emathrixacademy/petbottle/docs/sample.jpg

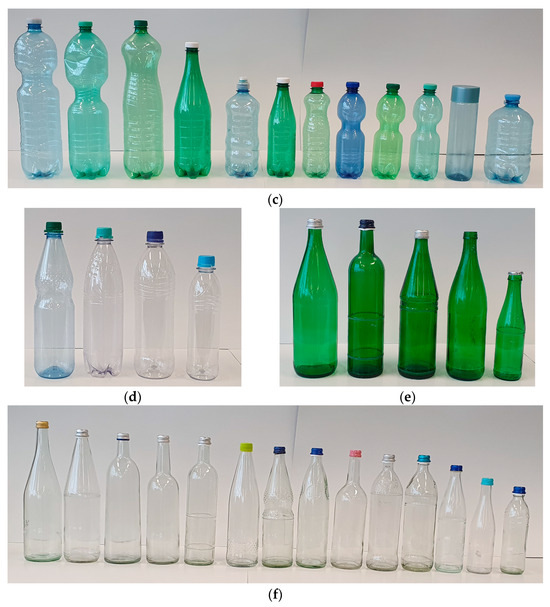
docs/sample.jpg
