emathrixacademy/petbottle/docs/PetBottle_Robotic_Arm_Schematic.pdf

## PET Bottle Robot - Complete Wiring Schematic

ESP32 | Raspberry Pi | Hailo-8 | 3x BTS7960B | L298N | 2x MG996R | 2x HC-SR04 | LCD I2C | 24V

## System Architecture Overview

The PET Bottle Collector Robot uses two processors:
1. Raspberry Pi 5 + Hailo-8 NPU: Camera vision (YOLOv5/v7/v8) + Navigation brain
2. ESP32: Motor control, ultrasonic sensors, WiFi AP, LCD display

Communication: Raspberry Pi connects to ESP32 WiFi AP (192.168.4.1) and sends HTTP commands. ESP32 provides sensor data via GET /sensor endpoint. Communication Diagram

Raspberry Pi 5 | ESP32 (WiFi AP)
+--------------------+ | WiFi | +------------------------+
| CSI Camera | | | | 192.168.4.1 | |
| Hailo-8 NPU | | | | | |
| YOLOv5/v7/v8 | | GET /sensor | | Ultrasonic L/R (cm) | |
| navigator.py <----+<----- JSON ----+--> HC-SR04 x2 | |
| Bottle detected? | | GET /cmd?c=F80 | Drive wheels (BTS7960) |
| Obstacle? | -----+---- command --->| Arm lift (BTS7960) | |
| Pickup! | -----+---- cmd?c=P --->| Servos (MG996R x2) | |
| | | | | Stepper base (L298N) | |
+--------------------+ | | LCD 16x2 + Buzzer | |
+------------------------+
Robot State Machine (navigator.py)
+--------+ | bottle | +------------+ | centered | +----------+
| ROAMING| detected | | APPROACHING| | & close | | ALIGNING |
| (S-curve+----------->| (drive to) +-------------->| (fine | |
| explore)| | +------+-----+ | | adjust) |
+----+----+ | | | +----+-----+
| | | lost bottle | |
| obstacle | | (15 frames) | | aligned
| detected | v | v
+----+----+ | +------+-----+ | +-----+------+
| AVOIDING| | | | ROAMING | | | PICKING UP |
| (back up| | | | | | | (ESP32 P | |
| & turn)| | +------------+ | | command) |
+---------+ | +-----+------+
| done
v
+-----+------+
| ROAMING |
+------------+

## ESP32 GPIO Pin Assignment (21 pins used)

GPIO | Component | Function | Dir
GPIO4 | BTS7960B #1 | Left Wheel RPWM | OUT
GPIO5 | BTS7960B #1 | Left Wheel LPWM | OUT
GPIO26 | BTS7960B #1 | Left Wheel EN | OUT
GPIO2 | BTS7960B #2 | Right Wheel RPWM | OUT
GPIO25 | BTS7960B #2 | Right Wheel LPWM | OUT
GPIO19 | BTS7960B #2 | Right Wheel EN | OUT
GPIO16 | BTS7960B #3 | Arm Lift RPWM | OUT
GPIO17 | BTS7960B #3 | Arm Lift LPWM | OUT
GPIO27 | BTS7960B #3 | Arm Lift EN | OUT
GPIO32 | L298N | Stepper IN1 | OUT
GPIO33 | L298N | Stepper IN2 | OUT
GPIO22 | L298N | Stepper IN3 | OUT
GPIO21 | L298N | Stepper IN4 | OUT
GPIO13 | MG996R Servo L | Left Servo Signal | OUT
GPIO18 | MG996R Servo R | Right Servo Signal | OUT
GPIO14 | LCD I2C | SDA (data) | I/O
GPIO15 | LCD I2C | SCL (clock) | OUT
GPIO23 | Buzzer | Alert Signal | OUT
GPIO12 | HC-SR04 x2 | Shared TRIG | OUT
GPIO34 | HC-SR04 Left | Left ECHO | IN
GPIO35 | HC-SR04 Right | Right ECHO | IN
Used: 21 pins | Free: GPIO 0, 36, 39
WiFi AP: PetBottle_Robot (192.168.4.1) | USB Serial: 115200 baud
GPIO34, GPIO35 = input-only pins (perfect for ultrasonic ECHO)

## 1. Ultrasonic Sensors - HC-SR04 x2 (Obstacle Avoidance)

About HC-SR04

- Measures distance via ultrasonic pulse echo (40kHz)
- Range: 2cm to 400cm, accuracy +/- 3mm
- Operating voltage: 5V
- Trigger pulse: 10us HIGH on TRIG pin
- ECHO pin returns HIGH pulse proportional to distance
- Distance (cm) = pulse duration (us) x 0.034 / 2
Wiring - Left Ultrasonic
HC-SR04 Pin | Connect To | Notes
VCC | 5V (DC-DC out) | Must be 5V, not 3.3V
TRIG | GPIO 12 | Shared with right sensor
ECHO | GPIO 34 | Input-only pin (safe for 5V*)
GND | Common GND | Shared ground

Wiring - Right Ultrasonic

HC-SR04 Pin | Connect To | Notes
VCC | 5V (DC-DC out) | Must be 5V, not 3.3V
TRIG | GPIO 12 | Shared with left sensor
ECHO | GPIO 35 | Input-only pin (safe for 5V*)
GND | Common GND | Shared ground

* GPIO 34/35 are input-only pins with no internal pull-up.
HC-SR04 ECHO outputs 5V. For safety, add a voltage divider:
ECHO --> [1K ohm] --> GPIO34/35 --> [2K ohm] --> GND
This divides 5V to ~3.3V. Many ESP32 boards tolerate 5V on input-only pins, but the divider is recommended.
Mounting Position

FRONT OF ROBOT
+---------------------+
[US-L] | [CSI Camera] | [US-R]
<-- | | lens | | -->
30deg | +--------+ | 30deg
| | [Arm / Servos] | |
+----+ | | +----+
| L | | | | R | Wheels
|Whl | | | |Whl |
+----+ | | +----+
| REAR OF ROBOT

Mount sensors at front corners

Angle outward ~30 degrees for wide coverage Height: same level as chassis (~10cm from ground)
Obstacle Avoidance Thresholds
Distance | Action | Details
< 15 cm | EMERGENCY STOP | Full stop, back up, turn away
15-40 cm | SLOW DOWN | Reduce speed to 50/255
40-60 cm | STEER AWAY | Turn away from closer side
> 60 cm | CLEAR | Full roaming speed (80/255)

ESP32 /sensor API Endpoint

GET http://192.168.4.1/sensor

Response (JSON):
{"left": 45, "right": 120,
"wheels": {"left": 80, "right": 80},
"base": 0, "lift": 0, "motors": 1}

Polled by Raspberry Pi at 10 Hz for real-time obstacle data.
Fused with camera person/object detection for 360-degree awareness.

## 2. Drive Wheels - BTS7960B (HW-039) x2

About the BTS7960B

- High-power 43A H-bridge motor driver
- Operating voltage: 5.5V to 27V (supports 24V directly)
- PWM frequency: up to 25 kHz
- Built-in thermal shutdown and overcurrent protection
- Each board: RPWM, LPWM, R_EN, L_EN, VCC, GND, B+, B-, M+, M-BTS7960B #1 - Left Drive Wheel (24V Motor)
BTS7960B Pin | Connect To | Notes
RPWM | GPIO 4 | Forward PWM (0-255)
LPWM | GPIO 5 | Reverse PWM (0-255)
R_EN | GPIO 26 | Enable (tied with L_EN)
L_EN | GPIO 26 | Enable (tied with R_EN)
VCC | 3.3V (ESP32) | Logic power
GND | Common GND | Shared ground
B+ | 24V Battery + | Via 10A fuse
B- | 24V Battery - | Motor power ground
M+ | Left Motor + | To left wheel motor
M- | Left Motor - | To left wheel motor

BTS7960B #2 - Right Drive Wheel (24V Motor)

BTS7960B Pin | Connect To | Notes
RPWM | GPIO 2 | Forward PWM (boot-safe pin)
LPWM | GPIO 25 | Reverse PWM (0-255)
R_EN | GPIO 19 | Enable (tied with L_EN)
L_EN | GPIO 19 | Enable (tied with R_EN)
VCC | 3.3V (ESP32) | Logic power
GND | Common GND | Shared ground
B+ | 24V Battery + | Via 10A fuse
B- | 24V Battery - | Motor power ground
M+ | Right Motor + | To right wheel motor
M- | Right Motor - | To right wheel motor

BTS7960B Control Logic

RPWM | LPWM | EN | Action
PWM | 0 | HIGH | Forward (variable speed)
0 | PWM | HIGH | Reverse (variable speed)

0 | 0 | HIGH | Coast stop
X | X | LOW | Disabled (emergency stop)

## 3. Arm Lift - BTS7960B #3 (58SW31ZY Motor)

Motor: 58SW31ZY DC Geared Motor

- Voltage: 12-24V DC (runs on 24V from battery)
- Speed: 16 RPM (geared down for torque)
- Used for: Robotic arm vertical lift mechanism
BTS7960B #3 Wiring
BTS7960B Pin | Connect To | Notes
RPWM | GPIO 16 | Lift UP PWM (0-255)
LPWM | GPIO 17 | Lift DOWN PWM (0-255)
R_EN | GPIO 27 | Enable (tied with L_EN)
L_EN | GPIO 27 | Enable (tied with R_EN)
VCC | 3.3V (ESP32) | Logic power
GND | Common GND | Shared ground
B+ | 24V Battery + | Via 10A fuse
B- | 24V Battery - | Motor power ground
M+ | 58SW31ZY + | To arm lift motor
M- | 58SW31ZY - | To arm lift motor

## 4. Base Platform - NEMA 17 Stepper via L298N

Motor: NEMA 17 (200 steps/rev, 1.8 deg/step)

- Used for: Circular turning platform (base rotation)
- Max rotation: +/- 270 degrees
- Driven in FULL4WIRE mode via AccelStepper library
- Coils released after each move to save power
L298N Wiring
L298N Pin | Connect To | Notes
+12V | 24V Battery | Motor power (L298N supports up to 35V)
GND | Common GND | Shared ground
IN1 | GPIO 32 | Stepper coil A+
IN2 | GPIO 33 | Stepper coil A-
IN3 | GPIO 22 | Stepper coil B+
IN4 | GPIO 21 | Stepper coil B-
ENA | Jumper ON | Full current to coil A
ENB | Jumper ON | Full current to coil B
OUT1/OUT2 | NEMA17 Coil A | Motor coil pair 1
OUT3/OUT4 | NEMA17 Coil B | Motor coil pair 2

## 5. Servo Motors - MG996R x2 (Left & Right Arm)

Left Servo (GPIO 13)

Servo Wire | Connect To | Notes
Orange/Signal | GPIO 13 | PWM control (50Hz, LEDC ch6)
Red/VCC | 5V (DC-DC out) | Dedicated 5V 2A+ source
Brown/GND | Common GND | Shared ground

Right Servo (GPIO 18)

Servo Wire | Connect To | Notes
Orange/Signal | GPIO 18 | PWM control (50Hz, LEDC ch7)
Red/VCC | 5V (DC-DC out) | Dedicated 5V 2A+ source
Brown/GND | Common GND | Shared ground
- Open = 0 deg, Close = 90 deg
- O = both open, C = both close
- WARNING: Each MG996R draws up to 2.5A stall.
Use a 5V DC-DC converter rated 5A+ for both servos.

## 6. LCD I2C Display (16x2)

LCD Pin | Connect To | Notes
SDA | GPIO 14 | I2C data line
SCL | GPIO 15 | I2C clock line
VCC | 5V (DC-DC out) | Display power
GND | Common GND | Shared ground
- I2C address: 0x27 (or 0x3F)
- Shows: wheel speed, base angle, lift status, IP address
- Updates every 500ms

## 7. Buzzer

GPIO 23 --> Buzzer (+)
GND --> Buzzer (-)

Active buzzer for startup beep, sequence feedback, emergency alerts.

## 8. Power Distribution

Complete Power Wiring Diagram

[24V 30000mAh ALEAIVY Battery]
[FUSE] | [FUSE] | [FUSE] | [L298N] | [DC-DC 24V->5V 5A]
10A | 10A | 10A | Stepper | |
[BTS#1] | [BTS#2] | [BTS#3] | +----> ESP32 VIN (5V)
L Wheel | R Wheel | Arm Lift | | | |
| | +-> 3.3V -> BTS VCC (x3)
+----> MG996R Left Servo VCC +----> MG996R Right Servo VCC +----> LCD I2C VCC
+----> Buzzer +
+----> HC-SR04 Left VCC
+----> HC-SR04 Right VCC

[ALL GNDs tied to battery negative]
Battery GND -- DC-DC GND -- ESP32 GND -- BTS GND (x3) -- L298N GND -- Servo GND (x2) -- LCD GND -- Buzzer GND -- HC-SR04 GND (x2)
Power Budget
Component | Voltage | Max Current
Left Drive Motor | 24V | 10A (stall)
Right Drive Motor | 24V | 10A (stall)
Arm Lift Motor | 24V | 5A (stall)
NEMA 17 Stepper | 24V | 1.5A
MG996R Servo x2 | 5V | 5A total (stall)
ESP32 | 5V | 0.5A
LCD I2C | 5V | 0.1A
HC-SR04 x2 | 5V | 0.1A
Buzzer | 5V | 0.05A

## 9. Raspberry Pi 5 + Hailo-8 NPU

Raspberry Pi Connections

The Raspberry Pi runs the vision system (YOLOv5/v7/v8) and navigator.
It connects to the ESP32 via WiFi - no physical wiring between them.
Pi Port | Connect To | Notes
CSI Camera | Pi Camera V2/V3 | Ribbon cable to CSI connector
M.2 slot | Hailo-8 NPU | AI accelerator for YOLO inference
USB-C | 5V 5A PSU | Official Pi 5 power supply
WiFi | ESP32 AP | SSID: PetBottle_Robot

Software Stack on Raspberry Pi

camera.py - YOLO model stitching (v5/v7/v8), detection & postprocessing
navigator.py - Autonomous brain: roaming, obstacle avoidance, bottle pickup server.py - OTA update server for remote code deployment

YOLO Models (Hailo HEF format):
yolov5s.hef | - 16 MB, COCO pretrained, FAR range specialist
yolov7.hef | - 55 MB, COCO pretrained, MID range specialist
yolov8s-coco.hef - 35 MB, COCO pretrained, CLOSE range specialist

Detection: COCO class 39 (bottle) - all orientations (standing, lying, tilted) Filtering: Bottles held by humans (COCO class 0) are excluded.
Toggle live: press 5/7/8/A during camera view to switch models.
Sensor Fusion

The navigator fuses two data sources for 360-degree awareness:

1. CAMERA (Raspberry Pi + Hailo-8):
- Detects bottles (target) and persons (avoid)
- Estimates distance by bounding box fill ratio
- Guides approach angle to center bottle in frame
2. ULTRASONIC (ESP32, via /sensor endpoint):
- Left and right distance readings (cm)
- Detects walls, furniture, obstacles camera cannot see
- Polled at 10 Hz over WiFi HTTP

Decision priority: Ultrasonic STOP > Camera person avoid > Bottle approach > Roam

## 10. Command Reference (Serial + WiFi)

USB Serial: 115200 baud | WiFi AP: PetBottle_Robot (petbottle123)
Web UI: http://192.168.4.1 | API: /cmd?c=<CMD> | Sensors: /sensor
Drive Wheels
Command | Description
F<speed> | Drive forward (0-255, default 80)
J<speed> | Drive backward (0-255)
TL<speed> | Turn left (left reverse, right forward)
TR<speed> | Turn right (left forward, right reverse)
W<l>,<r> | Raw wheel control (-255 to 255). E.g. W100,-50
X | Stop both wheels immediately

Base / Lift / Servos

Command | Description
B<angle> | Rotate base (-270 to +270 deg)
BH | Home base to 0 degrees
U<speed> | Lift arm UP (0-255)
D<speed> | Lift arm DOWN (0-255)
S | Stop lift motor
L<angle> | Left servo (0-180 deg)
R<angle> | Right servo (0-180 deg)
O | Both servos open (0 deg)
C | Both servos close (90 deg)

System

Command | Description
P | Full pickup sequence (lower, grab, lift, rotate, drop, home)
H | Home all motors (wheels stop, lift up, servos open, base 0)
E | EMERGENCY STOP - all motors off, EN pins LOW
? | Show help and current status

Pickup Sequence (Command: P)

1. Stop wheels, open both servos
2. Lower arm (speed 150, 3 seconds)
3. Close both servos (grab bottle)
4. Lift arm (speed 200, 3 seconds)
5. Rotate base to 180 degrees (bin on top)
6. Lower slightly (speed 120, 1 second)
7. Open both servos (release bottle into bin)
8. Lift arm back up (speed 200, 1.5 seconds)
9. Return to home position (base 0, servos open)

Triggered automatically by navigator.py when bottle is centered and close enough (fills >15% of camera frame).

## 11. Safety Notes

BOOT SAFETY:
- GPIO2 (Right RPWM) has built-in pull-down: stays LOW at boot.
- All EN pins start LOW (drivers disabled) until PWM is zeroed.
- Default speed: 80/255 (~31%) for safe testing.

FUSES: Add 10A fuse on each BTS7960B B+ line.

ULTRASONIC SAFETY:
- Add voltage divider (1K+2K) on ECHO lines for 5V->3.3V.
- 15ms delay between left/right readings prevents crosstalk.
- Timeout: 30ms (30000us) prevents blocking on no echo.

NAVIGATOR SAFETY:
- Emergency stop if ultrasonic < 15cm on either side.
- Camera detects persons - robot avoids if person fills >20% of frame.
- Pickup sequence stops wheels first, then operates arm.
- Lost WiFi: robot keeps last known sensor data, stops on timeout.

EMERGENCY STOP (E): Disables all motor drivers immediately. Send 'H' to re-enable and home all axes.

GROUND RULE: ALL GNDs must be tied together - battery, DC-DC, ESP32, BTS7960B (x3), L298N, servos, LCD, buzzer, HC-SR04 (x2).

## 12. Bill of Materials

Qty | Component | Model | Purpose
1 | ESP32 Dev Board | ESP32-D0WD | Motor/sensor controller
1 | Raspberry Pi 5 | RPi 5 4/8GB | Vision + navigation brain
1 | Hailo-8 NPU | M.2 module | YOLO AI accelerator
1 | Pi Camera | V2 or V3 | Bottle/obstacle detection
3 | BTS7960B Motor Driver | HW-039 | 43A H-bridge
1 | L298N Motor Driver | L298N | Stepper driver
2 | HC-SR04 Ultrasonic | HC-SR04 | Obstacle distance
2 | 24V DC Motor | - | Drive wheels (L/R)
1 | DC Geared Motor | 58SW31ZY | Arm lift
1 | Stepper Motor | NEMA 17 | Base rotation
2 | Servo Motor | MG996R | Left/Right arm grab
1 | LCD I2C Display | 16x2 PCF8574 | Status display
1 | Active Buzzer | - | Audio alerts
1 | Lithium Battery | 24V 30Ah | Main power
1 | DC-DC Converter | 24V->5V 5A | Logic/servo power
3 | Blade Fuse + Holder | 10A | Driver protection
2 | Resistor 1K ohm | - | Ultrasonic voltage divider
2 | Resistor 2K ohm | - | Ultrasonic voltage divider

Software Files

File | Description
robotic_arm.ino | ESP32 firmware: motors, sensors, WiFi AP, /sensor API
camera.py | YOLO v5/v7/v8 model stitching, detection, postprocessing
navigator.py | Autonomous brain: roam, avoid, approach, pickup
server.py | OTA update server for remote code deployment
yolov5s.hef | YOLOv5s COCO model (Hailo HEF, 16MB)
yolov7.hef | YOLOv7 COCO model (Hailo HEF, 55MB)
yolov8s-coco.hef | YOLOv8s COCO model (Hailo HEF, 35MB)
