emathrixacademy/petbottle/(commit log)

2026-02-27 add camera streaming functionality using Picamera2
2026-02-27 refactor camera streaming implementation and add Flask routes for live feed
2026-02-27 refactor camera.py to remove Flask integration and streamline camera preview functionality
2026-02-27 refactor camera.py to enhance frame generation and improve Flask integration for live video feed
2026-02-27 refactor camera.py to explicitly request RGB format and enhance HTML interface for better clarity
2026-02-27 refactor camera.py to improve camera initialization and enhance HTML interface for clarity
2026-02-27 refactor camera.py to enhance camera setup, enable HDR, and improve HTML interface for better clarity
2026-03-01 Refactor camera setup and remove YOLO integration for improved performance
2026-03-01 Refactor camera setup and integrate AI inference for object detection
2026-03-01 Refactor camera setup to replace YOLO with Hailo HEF acceleration for PET bottle detection
    [camera.py]
2026-03-01 Fix postprocessing for output shapes and improve anchor generation in PET bottle detection
    [camera.py]
2026-03-01 Refactor camera.py to enhance detection overlay, improve snapshot functionality, and update postprocessing logic
2026-03-01 Add initial test suite for camera functionality
2026-03-06 Fix camera capture: use picamera2 for Pi Camera CSI ribbon
    [camera.py]
2026-03-06 Fix --image single file path and hardcode petbottle output layer names
    [camera.py]
2026-03-06 Add debug max_conf print to diagnose zero detections
2026-03-06 Set default conf threshold to 0.01 for petbottle.hef, remove debug print
2026-03-06 Apply sigmoid to confidence output to fix low scores from HEF export
    [camera.py]
2026-03-06 Revert sigmoid (HEF already has it), set conf=0.01 for petbottle.hef
    [camera.py]
2026-03-06 Fix purple colors from picamera2 RGB output, reduce false positives
    [camera.py]
2026-03-06 Tighten NMS IoU to 0.3 and raise conf threshold to 0.05
    [camera.py]
2026-03-06 Raise conf to 0.25, add aspect ratio filter to reduce false positives
2026-03-06 Fix COCO model input size: read from HEF instead of hardcoding 416x416
    [camera.py]
2026-03-06 Replace aspect ratio filter with size+orientation filter to support laid-down bottles
    [camera.py]
2026-04-06 Add YOLO model stitching (v5/v7/v8), autonomous navigator, and ultrasonic obstacle avoidance
    - camera.py: YOLOv5/v7/v8 model stitching with live toggle (5/7/8/A keys),
    range-based specialization, held-by-human filtering, person detection
    - navigator.py: Autonomous brain fusing camera + ultrasonic sensors,
    state machine (roam/approach/align/pickup/avoid), ESP32 WiFi control
    - robotic_arm.ino: Added HC-SR04 ultrasonic sensors (GPIO 12/34/35),
    GET /sensor JSON endpoint for Pi communication
    - server.py: OTA update server for remote deployment
    - Updated wiring schematic PDF (12 pages) with full system architecture
    [partitions.csv]
2026-04-10 Fix right wheel reverse and backward: LEDC channel pairing + pin swap
    - Fix LEDC PWM: replace ledcAttachChannel (v3 API) with ledcSetup/ledcAttachPin
    (v2 API) for compatibility with ESP32 Arduino core 2.0.17
    - Fix channel pairing: assign channels in natural timer pairs (0/1, 2/3, 4/5)
    so each motor's forward/reverse share the same hardware timer — prevents
    the out-of-order timer re-init bug that killed right-wheel reverse (ch1)
    - Swap Right Wheel pins (2,25,19) with Arm Lift pins (16,17,27) to isolate
    potential BTS7960B hardware fault on the right driver board
    - Add flash_ota.bat: one-click compile + WiFi switch + OTA upload + reconnect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
2026-04-11 Add README/CLAUDE docs and cap drive wheel speed to 100
    - Add README.md: full project documentation (architecture, hardware, setup, API)
    - Add CLAUDE.md: project context for Claude Code (pin maps, build rules, known issues)
    - Cap wheel speed to DRIVE_MAX=100 (~39% duty) in set_wheels() for safety
    - Update web UI slider max from 255 to 100
2026-04-11 Add web detection app, fix Hailo-8 model configs, add OTA to sensor sketch
    - web_detect.py: Flask web app streaming live camera + YOLO detection via
    MJPEG at http://0.0.0.0:5000, with model switching (v5/v7/v8/ensemble)
    and real-time stats (FPS, inference time, bottle/person count)
    - camera.py: Switch to Hailo-8 native models (yolov5s_h8.hef, yolov7_h8.hef)
    with built-in NMS — fixes corrupted output from Hailo-8L compiled models.
    Fix ModelManager.activate() to activate network group before opening
    inference pipeline, and store activation context for proper cleanup.
    - petbottle/petbottle.ino: Add WiFi AP + WebServer + OTA firmware update
    (legacy sensor-only sketch, kept for refe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
    [camera.py]
2026-04-12 Cap drive speed to 80, update obstacle avoidance for 1m robot
    - robotic_arm.ino: DRIVE_MAX=80 (drivers explode above 100), default=60,
    web UI slider capped 30-80
    - navigator.py: all speeds under 80 (roam=60, turn=50, approach=40, slow=35),
    obstacle thresholds widened for 1m robot (stop=50cm, slow=80cm, turn=120cm)
    - camera.py: Hailo-8 native models with proper network group activation
    - web_detect.py: Flask web app for browser-based detection viewing
    - robotic_arm.bin: pre-compiled firmware ready for OTA flash
    [navigator.py]
2026-04-13 Restructure repo, white-blue web UI, fix ARM_IN1 strapping pin, add static IPs
    - Reorganize files into esp32_test/, raspi/, models/, docs/, tools/
    - Redesign ESP32 web dashboard and OTA page with clean white and blue theme
    - Fix ARM_IN1: GPIO 0 (strapping pin) -> GPIO 15 to prevent flash lockout
    - Invert arm motor polarity in software (up button was going down)
    - Add limit switch auto-detect: skip check when no pull-ups installed
    - Lock ESP32 AP to static IP 192.168.4.1 via softAPConfig
    - Add Pi static IP 192.168.4.4 config in setup_hailo.sh
    - Fix setTab() implicit event variable bug
    - Remove dead ANSI escape code in pollCmdLog
    - Delete old build artifacts and legacy sketches
    - Update CLAUDE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
    [partitions.csv]
2026-04-16 Clean repo: add Hailo driver tooling, tune arm/swing UI ranges, ignore large binaries
    - esp32_test: arm slider 25-180, swing slider 30-80 (was 50-255)
    - Add .gitignore entries for *.log, fromgooglecolab/, models/archive/
    - Remove large model binaries from tracking (backed up separately)
    - Remove legacy raspi/sample.py and raspi/web_detect.py
    - Add YOLOv8 PET bottle training notebook
2026-04-18 Add Pi fallback AP, swap arm to Hybrid 2R0, refine obstacle UI
    - raspi/setup_fallback_ap.sh: Pi self-sufficient access — broadcasts
    PiRobot hotspot (192.168.50.1) when no known WiFi in range, watchdog
    auto-switches back when a known SSID reappears. Removes reliance on
    Tailscale / phone-hotspot tricks for SSH access.
    - esp32_test.ino: arm lift moved from L298N #1 to e-Gizmo Hybrid 2R0
    (PWM=14, DIR=19). DIR off GPIO 15 (strapping pin); GPIO 15 reused
    for E18-D80NK IR proximity sensor. Added manual pulsed-down safety
    profile, mirrored servo scoop angles, lowered default arm speed.
    - pi_admin.py: four-tier obstacle coloring (stop/slow/warn/clear)
    matching navigator thresholds (60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
    [esp32_test.ino, pi_admin.py]
2026-04-19 USB-serial transport, IR bin-full mission end, safety hardening
    - Swap Pi<->ESP32 control link from WiFi/HTTP to USB serial (115200 baud,
    line-based ASCII + 10 Hz JSON sensor push). Adds ESP32SerialLink with
    port auto-detect and background reader thread.
    - End mission on E18-D80NK IR proximity sensor (debounced) instead of a
    fixed bottle count. MISSION_COMPLETE is sticky until operator restart.
    - ESP32 wheel watchdog: stop motors if no Pi command for >1 s.
    - Web /cmd auto-locks while Pi serial is active (PISTOP/PIX/PA exempt).
    - Clamp swing PWM to 150; reset verify/approach counters on AVOIDING;
    AVOIDING re-checks front clearance before resuming SCANNING.
    - All ESP32 motor speeds def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
    [camera.py, esp32_test.ino, navigator.py]
2026-04-19 Restore arm lift motor speeds, default all sliders to 30
    Arm/pickup speeds were accidentally zeroed out, disabling the motor.
    Restored working values (127/180/100/255) and set default UI slider
    and armSpeed to 30 for a gentler start.
2026-04-19 Include .bin firmware in repo for OTA flashing
    Updated .gitignore to track .bin files in build directories.
    Added compiled esp32_test.ino.bin.
2026-04-20 Lower arm down speed to 80 to reduce motor stress
    Reduced MANUAL_DOWN_SPEED (127→80) and PU_LOWER_SPEED (100→80)
    for gentler pulsed lowering, preventing motor damage.
    [esp32_test.ino]
2026-04-20 Set arm default speed to 20, cap max at 120
    Reduced arm PWM defaults and slider range for motor protection.
    MANUAL_UP_SPEED capped at 120 to match new max.
2026-04-20 Restore arm max speed to 180
    Slider max and MANUAL_UP_SPEED back to 180, default stays at 20.
2026-04-20 Replace USB serial with BLE UART for Pi-ESP32 communication
    ESP32 now runs a BLE GATT server (Nordic UART Service) advertising
    as "PetBottle_Robot". Pi navigator connects via bleak library.
    Same PI-prefixed command protocol, same JSON sensor packets.
    - ESP32: added BLE server with TX notify + RX write characteristics
    - Pi: replaced pyserial ESP32SerialLink with bleak ESP32BLELink
    - Sensor push slowed from 100ms to 200ms for BLE throughput
    - USB Serial kept for Arduino IDE debug only, not Pi commands
    - WiFi AP still available for OTA and web dashboard
    - CLAUDE.md updated to reflect BLE transport
    [esp32_test.ino, navigator.py]
2026-04-20 Fix BLE connection: force LE transport, increase timeout
    - Added transport="le" to prevent BlueZ classic BT fallback
    - Increased connection timeout to 20s (ESP32 WiFi+BLE coexistence)
    - Increased init wait to 30s for slower BLE discovery
    - Explicit connect/disconnect for better error recovery
    [navigator.py]
2026-04-20 Add model switching, data logging, full dashboard to navigator
    - YOLOv5/v7/v8 model switch buttons on dashboard
    - CSV data recording: detections, bottle distance, avoidances, pickups
    - Ultrasonic distance display with color coding
    - BLE connection status indicator
    - Pi->ESP32 command log panel
    - Download CSV log for model comparison
    - Non-blocking BLE: camera starts immediately, ESP32 connects in background
    [navigator.py]
2026-04-20 Update pi_admin dashboard: WiFi → BLE status, add cmd log + nav CSV
    - Replace WiFi connect/disconnect with live BLE status from navigator
    - Add pickups/avoidances counters to detection stats
    - Add Pi→ESP32 command log panel (polled from navigator)
    - Add navigation CSV download button
    - Add MISSION_COMPLETE state color
    - Remove unused nmcli/WiFi routes and imports
    - Add pi_admin.py to CLAUDE.md key files
    [pi_admin.py]
2026-04-20 Fix web UI turning: set default wheelSpeed and turnSpeed to 40
    turnSpeed and wheelSpeed were 0, so web UI left/right turn commands
    did nothing (setLeft(0), setRight(0)). Pi commands unaffected since
    they pass their own speed values.
    [esp32_test.ino]
2026-04-20 Fix wheel speeds: forward/backward fixed at 60, turn default 50 adjustable
    - wheelSpeed is now const 60 — no way to change via UI or commands
    - turnSpeed defaults to 50, adjustable with +/- buttons
    - Pi navigator commands (PIFW/PIBW/PITL/PITR) keep variable speed for navigation
    [esp32_test.ino]
2026-04-22 Swap LIMIT_2/IR_PROX pins, slow arm down, extend servo wait times
    - Swap GPIO 39 (LIMIT_2) → GPIO 15 (internal pull-up) to fix always-pressed issue
    - Swap GPIO 15 (IR_PROX) → GPIO 39 (needs external 10k pull-up)
    - Reduce manual arm down speed from 80 to 60 PWM
    - Increase scoop close and drop open wait from 800ms to 1000ms
    [esp32_test.ino]
2026-04-22 Switch Pi-ESP32 communication from BLE to WiFi HTTP, add Pi OTA upload
    - Replace ESP32BLELink with ESP32WiFiLink in navigator.py
    (commands via GET /cmd?c=, sensor polling via GET /sensor every 200ms)
    - Remove bleak dependency, use urllib instead
    - Update pickup servo wait times to 3000ms
    - Add /upload page to pi_admin.py for OTA Python file updates
    - Update dashboard labels from BLE to WiFi
    [esp32_test.ino, navigator.py, pi_admin.py]
2026-04-22 Switch Pi-ESP32 communication from BLE to WiFi HTTP, add Pi OTA upload
    - Remove all BLE code from ESP32 firmware (82% → 41% flash)
    - Pi navigator uses WiFi HTTP: GET /cmd?c=<CMD> and GET /sensor
    - WiFi-only = more stable, no BLE coexistence issues
    - Dashboard shows WiFi connection status instead of BLE
    - Pi auto-connects to ESP32 WiFi AP on boot
    [esp32_test.ino, navigator.py, pi_admin.py]
2026-04-22 Swap LIMIT_2/IR_PROX pins, slow arm down, extend servo wait times
    - Scoop close wait: 3s → 1s for faster grab
    - Drop open wait: 3s → 10s to ensure bottle falls into bin
    - Lift speed at max 255
    - Removed BLE stack (WiFi-only communication)
    [esp32_test.ino]
2026-04-22 Fix PISTOP to abort pickup, navigator stop uses emergency_stop, add wiring schematic
    - ESP32: PISTOP now calls pickupAbort() before stopAll() so pickup sequence truly stops
    - Navigator: /stop route sends PISTOP (emergency_stop) instead of PIX (wheels only)
    - Add WIRING_SCHEMATIC.md with full ASCII wiring diagrams
    [esp32_test.ino, navigator.py]
2026-04-26 Switch Pi-ESP32 communication from WiFi AP to mobile hotspot STA mode
    ESP32 now connects to phone hotspot as STA client (static IP 192.168.43.100)
    instead of running its own AP. Stronger signal, better range, internet access
    for both devices. Removed all BLE references from codebase and docs.
2026-04-26 Update hotspot SSID to petbottle_hotspot to avoid conflict with ESP32 AP name
    [esp32_test.ino]
2026-04-26 Set device hostnames: esp32_petbottle and raspi_petbottle
2026-04-26 Remove static IP, add auto-discovery so ESP32 works on any phone hotspot
    Navigator scans the local network for the ESP32's /sensor endpoint at
    startup. Works regardless of what subnet the phone DHCP assigns.
2026-04-26 Add AI vision verification and scene analysis to navigator
    - verify_target: confirms PET bottle after YOLO detection (VERIFYING state)
    - analyze_scene: suggests navigation direction when scanning finds nothing
    - assess_obstacle: identifies obstacles and recommends avoidance direction
    All AI calls run in background threads to avoid blocking the main loop.
    Falls back to YOLO-only if API is unavailable.
    [navigator.py, vision_ai.py]
2026-04-26 Add manual controls dashboard and PI-prefixed commands for all actuators
    ESP32: Add PIAU/PIAD/PIAS (arm), PISWL/PISWR/PISWS (swing), PISO/PISC
    (servos), PIBZ/PIBZL (buzzer) commands that bypass mode system.
    Pi dashboard: Reorganize into 3 tabs (Autonomous, Manual Control, Data)
    with touch-friendly D-pad, speed slider, arm/swing/servo/buzzer controls,
    live sensor readout, and pickup sequence buttons. All commands route
    through Pi to ESP32 via WiFi HTTP.
    [esp32_test.ino, pi_admin.py]
2026-04-27 Update arm lift: soft ramp-up, continuous motion, servo swap labels, servos open on boot
    - Remove pulsed arm motion, use continuous drive (stable 19V/12V supply)
    - Add soft ramp-up on arm lift to avoid PSU overcurrent trip
    - Servos open on boot for scooper replacement
    - Swap servo Open/Close button labels to match actual wiring
    - Remove PI arm/swing/servo/buzzer commands (wheel + stop only)
    - Slower pickup sequence timing, 45s timeout
    - Update flash_ota.bat for esp32_test sketch
    [esp32_test.ino]
2026-04-27 Update arm lift: reduce manual down speed from 60 to 35 PWM
2026-04-27 Update arm lift: soft ramp-up, continuous motion, servo swap labels, servos open on boot
    [esp32_test.ino]
2026-04-28 Fix inverted scooper servos: swap OPEN/CLOSE values so scoopers match real-world direction
    [esp32_test.ino]
2026-04-28 Fix navigator exiting when ESP32 not yet on hotspot — retry discovery forever
    The navigator was exiting immediately if ESP32 wasn't found during the
    first 30s scan. Now it retries every 10s until the ESP32 joins the
    hotspot, so boot order no longer matters.
    [navigator.py]
2026-04-28 Fix critical bug: set lastPiCmdMs on PI commands so watchdog doesn't kill wheels
    Without this, the wheel watchdog (1s timeout) immediately stops all wheel
    movement during autonomous mode because lastPiCmdMs was never updated.
    The wheels would start spinning then stop 1 second later.
    [esp32_test.ino]
2026-04-28 Fix ESP32 disconnect during autonomous: deduplicate commands to prevent flooding
    Navigator was sending the same motor command (PITL/PITR) 52 times per
    second (once per frame). The ESP32's single-threaded web server choked,
    causing timeouts and disconnects. Now identical consecutive commands are
    skipped — only state changes trigger a new HTTP request.
    [navigator.py]
2026-04-28 Fix all autonomous mode blockers: sensor resilience, state transitions, throttling
    - /start now accepts STOPPED and MISSION_COMPLETE states (not just WAITING)
    - Command throttle: 150ms minimum between commands, full dedup including PIX
    - Sensor poll: requires 5 consecutive failures before declaring disconnect
    (was: 1 failure instantly killed connection and forced STOPPED)
    - SENSOR_STALE raised from 2s to 5s (WiFi jitter tolerance)
    - INFER_FAIL_LIMIT raised from 3 to 15 (don't force STOPPED on transient errors)
    [navigator.py]
2026-04-28 Fix ECHO_4 pin: was GPIO 0 (boot pin, garbage readings) now correct GPIO 34
    GPIO 0 is a boot strapping pin that gives unreliable readings as an
    ultrasonic echo input. This caused false close-distance readings on
    sensor S4 (left), triggering unnecessary obstacle avoidance during
    autonomous mode. Fixed to GPIO 34 per the schematic.
    [esp32_test.ino]
2026-04-28 Fix emergency stop, servo direction, swing drive, auto-start, and command routing
    - Emergency stop: background threads (pickup, AI scan, AI verify) now
    respect WAITING state instead of overwriting it back to SCANNING.
    WAITING/STOPPED states send PISTOP every 2s as safety net.
    - Servo direction swapped: OPEN_L=0/OPEN_R=180, CLOSE_L=180/CLOSE_R=0
    - Arm speeds adjusted: UP=153, DOWN=40
    - Swing speed set to 35, separate dedup tracking (2s window) so swing
    commands don't get blocked by wheel command dedup
    - Removed headless stdin auto-start — autonomous only starts via
    dashboard button (/start route), not automatically on ESP32 connect
    - Pi admin emergency stop routes through navigator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
    [esp32_test.ino, navigator.py, pi_admin.py]
2026-04-29 Update scanning duration and camera status tracking
    Increased SCAN_DURATION to allow for longer scanning time and added cameraOk status to stream_stats.
2026-04-29 Fix bottle avoidance, arm speeds, and rebuild firmware
    - navigator.py: robot now approaches bottles instead of avoiding them
    when ultrasonic triggers during SCANNING/ROAMING with a bottle in sight
    - navigator.py: fix _start_pickup polling — wait for ESP32 to leave idle
    before declaring pickup done (prevents premature exit)
    - esp32_test.ino: arm down speed 25 -> 35 (MANUAL_DOWN_SPEED, PU_LOWER_SPEED)
    - esp32_test.ino: arm lift speed remains 153 (MANUAL_UP_SPEED, PU_LIFT_SPEED)
    - build_test/: recompiled firmware bin with updated speeds
    [camera.py, esp32_main.ino, esp32_test.ino, generate_schematic_pdf.py, navigator.py, pi_admin.py, server.py, vision_ai.py]
2026-04-30 Fix updateAutoBtn to disable Start when ESP32 or navigator is offline
    updateAutoBtn was always enabling the button regardless of connection state.
    Now shows 'WAITING FOR ESP32...' (disabled) when _espOk=false and
    'NAVIGATOR OFFLINE' (disabled) when _navOk=false — restoring the guard
    that was lost during the merge conflict resolution.
    [pi_admin.py]
2026-04-30 Add WiFi auto-reconnect in loop() so ESP32 recovers from dropped connections
2026-05-02 Modifed firmware version of ESP32 MCU
